ElectronAsh/MiSTer_Vector/README.md

# MiSTer_Vector
Vector X/Y/Z/R/G/B DAC Board for MiSTer

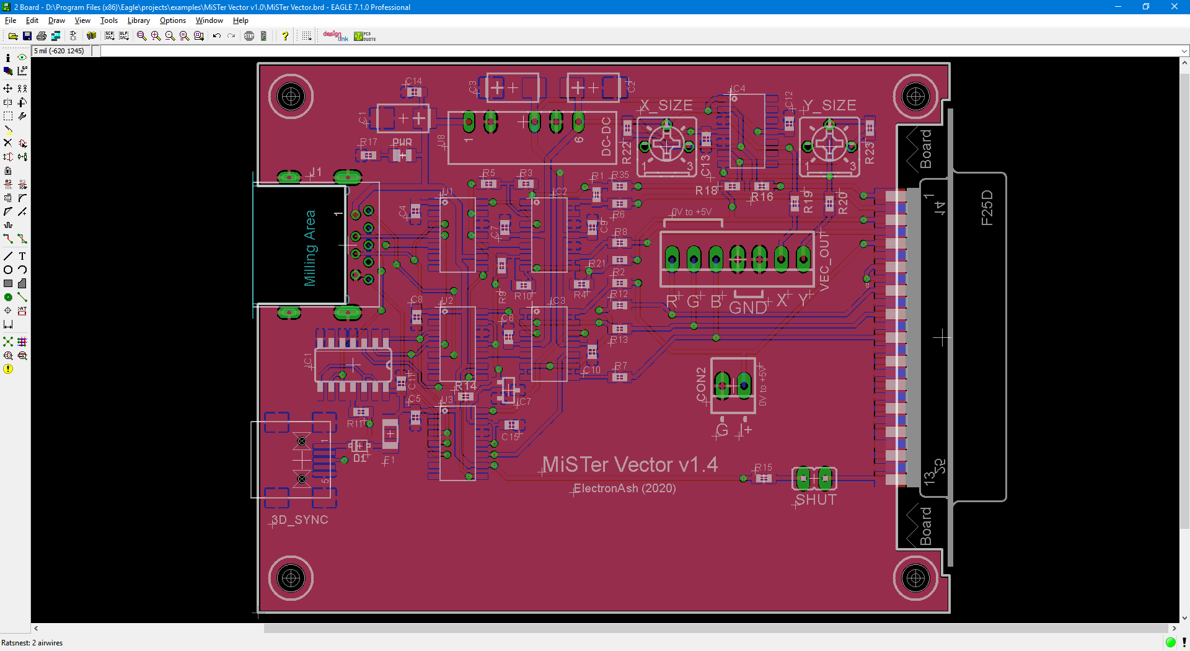
[picture p1: vector_dac_v1_4_PCB.png]
