ElectronAsh/MiSTer_Vector/MiSTer Vector.brd

## EAGLE design MiSTer Vector.brd (2020-01-31)

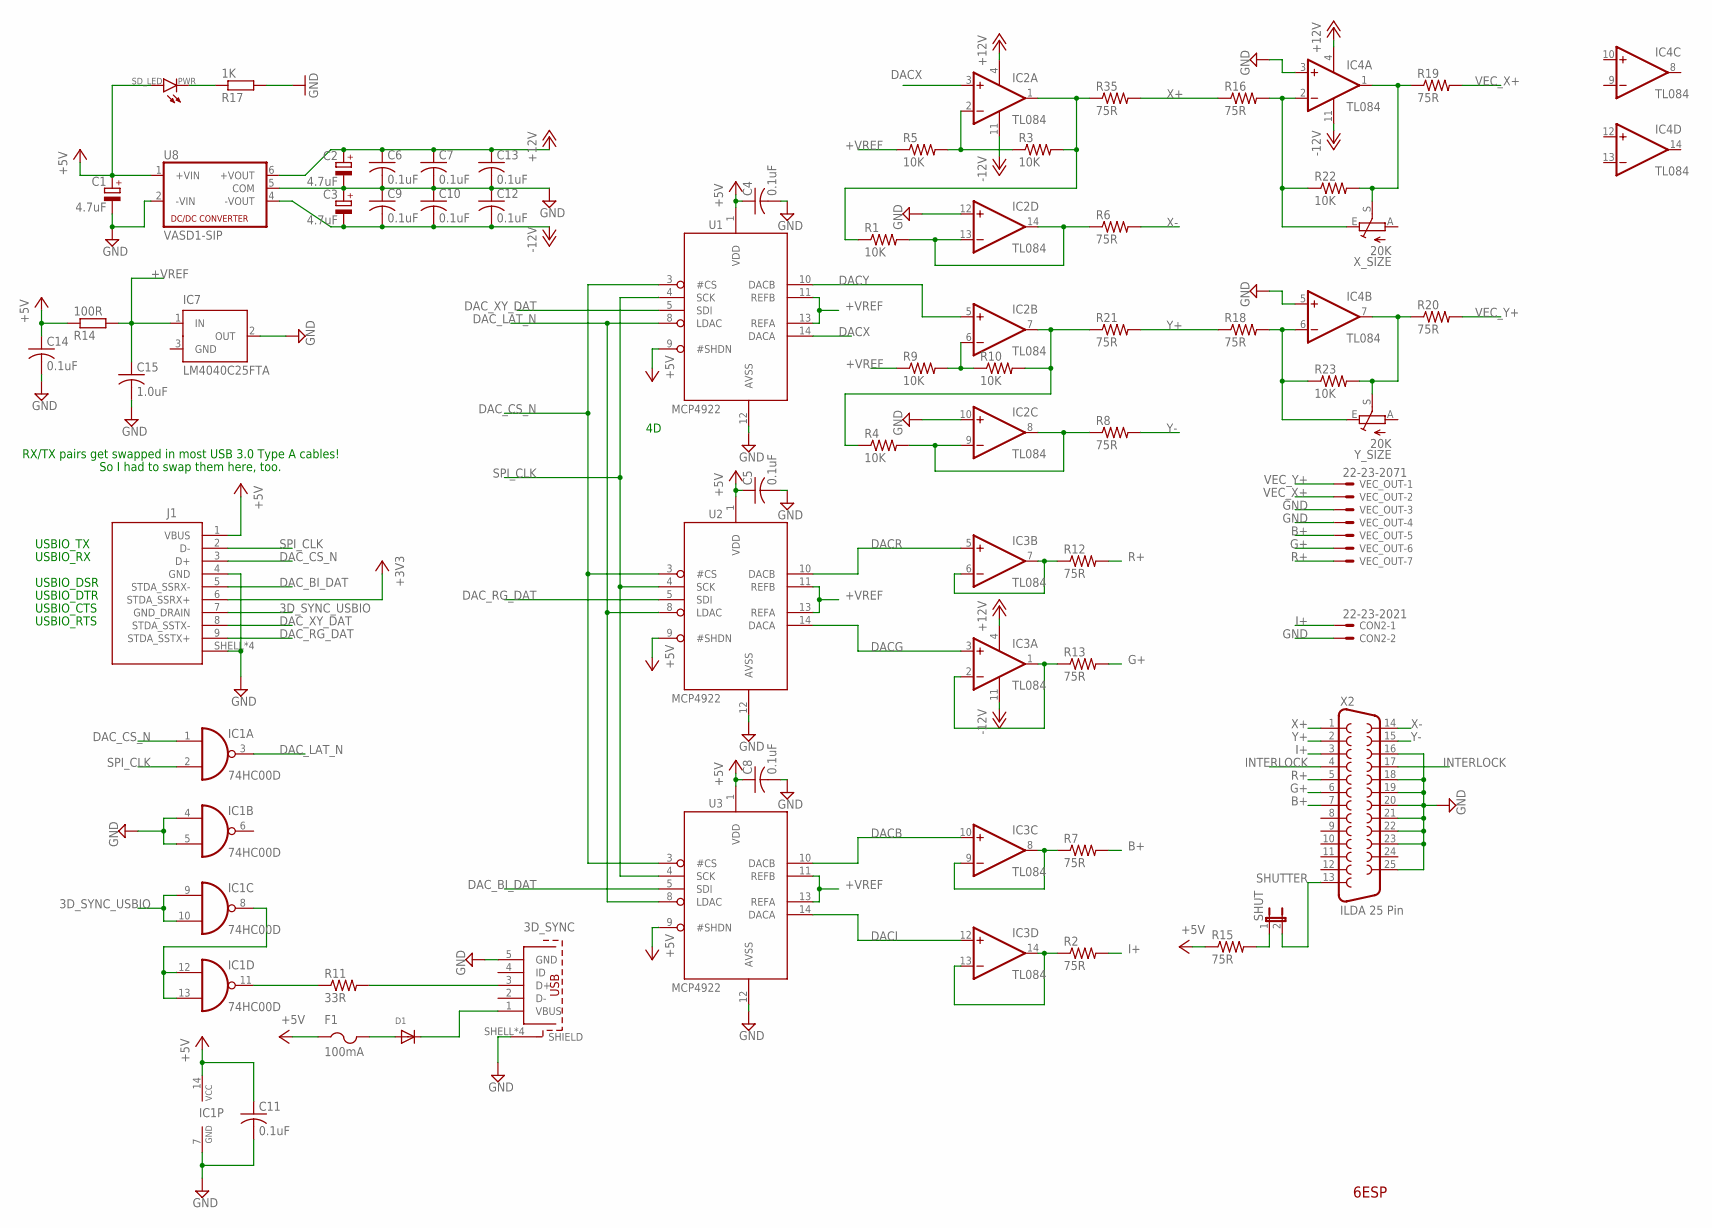
[picture p2: schematic MiSTer Vector.sch]

Parts:
3D_SYNC: 65100516121
C1, C2, C3: 4.7uF; CT6032
C4, C5, C6, C7, C8, C9, C10, C11, C12, C13, C14: 0.1uF; C0603
C15: 1.0uF; C0603
CON2: 22-23-2021
D1: DIODESOD-323F; SOD-323F
F1: 100mA; R1206
IC1: 74HC00D; SO14
IC2, IC3, IC4: TL084; SOIC-14
IC7: LM4040C25FTA; SOT23
J1: 692121230100
PWR: SD_LED; 0805_POL
R1, R3, R4, R5, R9, R10, R22, R23: 10K; R0603
R2, R6, R7, R8, R12, R13, R15, R16, R18, R19, R20, R21, R35: 75R; R0603
R11: 33R; R0603
R14: 100R; R0603
R17: 1K; R0603
SHUT: JP1E; JP1
U1, U2, U3: MCP4922; SOIC-14
U8: VASD1-SIP; NMA
VEC_OUT: 22-23-2071
X2: ILDA 25 Pin; F25D
X_SIZE: 20K; B25P
Y_SIZE: 20K; B25P

Connections:
3D_SYNC_USBIO: IC1.9 (I0), IC1.10 (I1), J1.7 (GND_DRAIN)
+3V3: J1.6 (STDA_SSRX+)
+5V: C1.+, C4.1, C5.1, C8.1, C11.1, C14.1, F1.1, IC1.14 (VCC), J1.1 (VBUS), PWR.+ (A), R14.1, R15.1, U1.1 (VDD), U1.9 (#SHDN), U2.1 (VDD), U2.9 (#SHDN), U3.1 (VDD), U3.9 (#SHDN), U8.1 (+VIN)
+12V: C2.+, C6.1, C7.1, C13.1, IC2.4 (V+), IC3.4 (V+), IC4.4 (V+), U8.6 (+VOUT)
+VREF: C15.1, IC7.1 (IN), R5.1, R9.1, R14.2, U1.11 (REFB), U1.13 (REFA), U2.11 (REFB), U2.13 (REFA), U3.11 (REFB), U3.13 (REFA)
-12V: C3.-, C9.2, C10.2, C12.2, IC2.11 (V-), IC3.11 (V-), IC4.11 (V-), U8.4 (-VOUT)
B1+: IC3.8 (OUT), IC3.9 (-IN), R7.1
B+: R7.2, VEC_OUT.5, X2.7
DACB: IC3.10 (+IN), U3.10 (DACB)
DACG: IC3.3 (+IN), U2.14 (DACA)
DACI: IC3.12 (+IN), U3.14 (DACA)
DACR: IC3.5 (+IN), U2.10 (DACB)
DACX: IC2.3 (+IN), U1.14 (DACA)
DACY: IC2.5 (+IN), U1.10 (DACB)
DAC_BI_DAT: J1.5 (STDA_SSRX-), U3.5 (SDI)
DAC_CS_N: IC1.1 (I0), J1.3 (D+), U1.3 (#CS), U2.3 (#CS), U3.3 (#CS)
DAC_LAT_N: IC1.3 (O), U1.8 (LDAC), U2.8 (LDAC), U3.8 (LDAC)
DAC_RG_DAT: J1.9 (STDA_SSTX+), U2.5 (SDI)
DAC_XY_DAT: J1.8 (STDA_SSTX-), U1.5 (SDI)
G1+: IC3.1 (OUT), IC3.2 (-IN), R13.1
G+: R13.2, VEC_OUT.6, X2.6
GND: 3D_SYNC.5 (GND), 3D_SYNC.SHELL (SHIELD), 3D_SYNC.SHELL1 (SHIELD), 3D_SYNC.SHELL2 (SHIELD), 3D_SYNC.SHELL3 (SHIELD), C1.-, C2.-, C3.+, C4.2, C5.2, C6.2, C7.2, C8.2, C9.1, C10.1, C11.2, C12.1, C13.2, C14.2, C15.2, CON2.2, IC1.4 (I0), IC1.5 (I1), IC1.7 (GND), IC2.10 (+IN), IC2.12 (+IN), IC4.3 (+IN), IC4.5 (+IN), IC7.2 (OUT), IC7.3 (GND), J1.4 (GND), J1.SHELL (SHIELD), J1.SHELL1 (SHIELD), J1.SHELL2 (SHIELD), J1.SHELL3 (SHIELD), R17.2, U1.12 (AVSS), U2.12 (AVSS), U3.12 (AVSS), U8.2 (-VIN), U8.5 (COM), VEC_OUT.3, VEC_OUT.4, X2.16, X2.18, X2.19, X2.20, X2.21, X2.22, X2.23, X2.25
I1+: IC3.13 (-IN), IC3.14 (OUT), R2.1
I+: CON2.1, R2.2, X2.3
INTERLOCK: X2.4, X2.17
unnamed: IC2.1 (OUT), R1.1, R3.2, R35.1
unnamed: IC2.7 (OUT), R4.1, R10.2, R21.1
unnamed: IC2.6 (-IN), R9.2, R10.1
unnamed: IC2.8 (OUT), IC2.9 (-IN), R4.2, R8.1
unnamed: IC2.13 (-IN), IC2.14 (OUT), R1.2, R6.1
unnamed: 3D_SYNC.1 (VBUS), D1.C
unnamed: IC1.11 (O), R11.1
unnamed: IC1.8 (O), IC1.12 (I0), IC1.13 (I1)
unnamed: 3D_SYNC.3 (D+), R11.2
unnamed: PWR.- (C), R17.1
unnamed: D1.A, F1.2
unnamed: R15.2, SHUT.1
unnamed: IC4.2 (-IN), R16.2, R22.1, X_SIZE.E
unnamed: IC4.6 (-IN), R18.2, R23.1, Y_SIZE.E
unnamed: IC4.7 (OUT), R20.1, R23.2, Y_SIZE.S
unnamed: IC4.1 (OUT), R19.1, R22.2, X_SIZE.S
unnamed: IC2.2 (-IN), R3.1, R5.2
R1+: IC3.6 (-IN), IC3.7 (OUT), R12.1
R+: R12.2, VEC_OUT.7, X2.5
SHUTTER: SHUT.2, X2.13
SPI_CLK: IC1.2 (I1), J1.2 (D-), U1.4 (SCK), U2.4 (SCK), U3.4 (SCK)
VEC_X+: R19.2, VEC_OUT.2
VEC_Y+: R20.2, VEC_OUT.1
X+: R16.1, R35.2, X2.1
X-: R6.2, X2.14
Y+: R18.1, R21.2, X2.2
Y-: R8.2, X2.15

Notes on the sheet:
6ESP
USBIO_TX
USBIO_RX
USBIO_DSR
USBIO_DTR
USBIO_CTS
USBIO_RTS
RX/TX pairs get swapped in most USB 3.0 Type A cables!
So I had to swap them here, too.

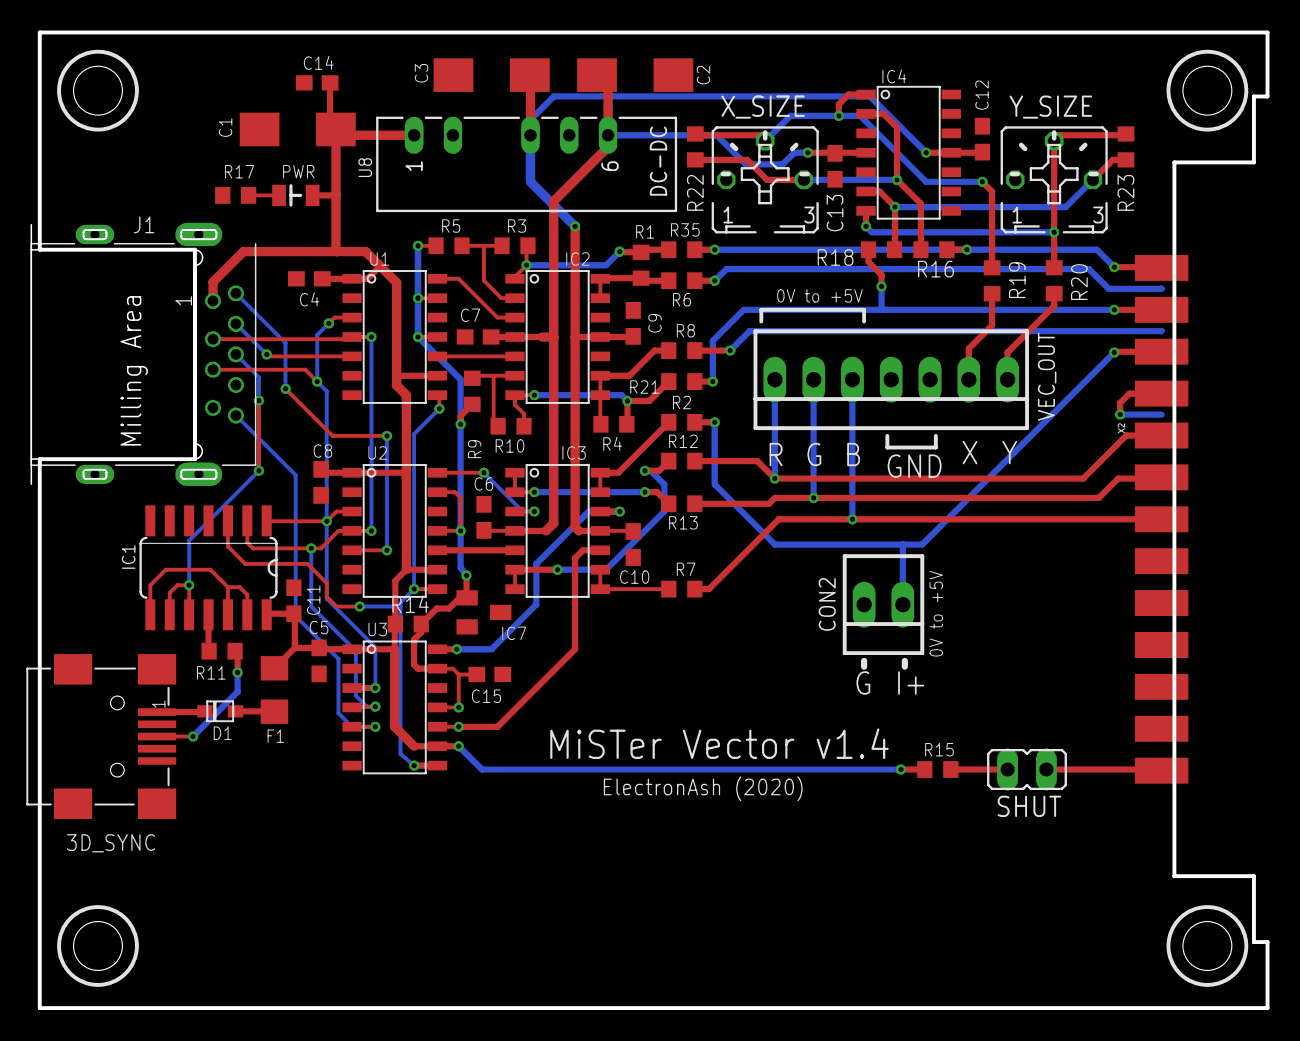
[picture p3: board MiSTer Vector.brd from above]

Board: 2 copper layers, 80.9 x 63.9 mm, 59 parts (0 on the bottom side), 51 nets.
