ElectronAsh/MiSTer_Vector/(threads)

Thread 1 (2020-12-24):

Faster Dac possible? LTC2666

BugWhacker, 2020-12-24:
Would using 1 - LTC2666 Dac running @ 50mhz allow for faster drawing rates? [https://www.analog.com/media/en/technical-documentation/data-sheets/2666fa.pdf](url)

I seems like it would allow for not only faster SPI bus speeds but also less overhead since you can load all registers at once. I have an evaluation board and would be more than willing to try the code out on it if it is something you are interested in working on.

ElectronAsh, 2020-12-25:
Hi,

After testing the prototype DAC, I found that it still wasn't really fast enough for even the Vectrex core.

The SPI DAC does update the X/Y, R/G, and B/I DACs at once from the core, but even when overclocking SPI to 24 MHz, it's still not fast enough, sadly.

(I really should have done a better README on this repo, but I forgot. lol)

It's not so much the update rate from the core itself as the logic used to emulate the analog integration/interpolation, which updates at a much higher rate.

The vector output from the current DAC isn't great.
There's just not enough definition there to really call it usable.

I did look into few other SPI DACs, but I don't think any of them will be quite fast enough either.

The LTC2666 requires a minimum of 24 clock cycles just to update one DAC (or you can latch that same value into multiple DACs).

So at 50 MHz SPI, you would only be able to update each DAC output at around 2 MHz. Which sounds like it would be fast enough, but I also had the issue of the value from the core updating asyncronously to the DAC.

Since you ideally need to shift the data into two DACs before latching (for X/Y), that further reduces the update rate to around 1 MHz.

Using the USERIO port on MiSTer probably wouldn't quite reach 50 MHz reliably either, as the IO Boards have 100R series resistors and 10K pull-ups on all IO pins.

The MiSTer framework logic uses open-drain style outputs now.
(Although you could just force that to push-pull style on the core, it's probably not ideal for some other USERIO add-ons like SNAC were left plugged in.)

I recently designed an ITX/DTX board for MiSTer, though, which has some latches and an ADV7123 DAC for the Vector output...

https://twitter.com/AshEvans81/status/1335018482472263682?s=20

Using two of the ADV's 10-bit DACs for X/Y, and one of the latches for 18-bit RGB, I should be able to very quickly alternate between the two, updating them from the parallel GPIO bus, and updating at a MUCH faster rate.

As a way of enabling the new Vector DAC (and disabling the normal VGA/RGB output), I put a small ATmega on the board which is hooked up to the I2C bus on the DE10's "RTC" header.

(the idea being that when a Vector DAC enabled core is active, it will keep sending out a core ID via I2C, so the ATmega can switch over to the proper DAC.)

For now though, I'll just be forcing those signals during testing.
I just haven't had chance to finish soldering the ADV DAC and the rest of the passives. lol

The only other way I thought it may be doable via USERIO is latching four bits at a time to parallel DACs.
But when I did some calcs for that, I dont think it worked out that much faster than updating all six DACs at once (XYRGBI) via SPI.

If a specific vector core doesn't need full RGB colour, then it might be worth lookng into again in the future.

I'll probably end up deleting this SPI DAC repo eventually, tbh, as I don't think it's quite viable now.
There are some other vector cores being released very soon though, and maybe the SPI DAC will work better with some of those?

Thanks for your suggestion. It's always worth looking into other options. ;)

I'll keep this issue open, and let you know if the new DAC works out.

BugWhacker, 2020-12-26:
Thank you for answering, I have been following your work for awhile and enjoy hacking at hardware myself. I wonder if you could feed the signal out over usb like is being done with the Raspberrypi and advanced Mame. I have one of the boards and it is nothing more than an A-tiny interpeting a usb feed from the pi (or a pc) and dumping an Spi stream into some parralel dacs. It works really well and if it was fpga instead of mame emulation I would be completly happy.

I have been working on a jamma daughter board that I am really happy with the results of so far and having vector support for the mister is a holy grail project for me so I hope you keep working at it or at least dont delete the work you have done already.

If you ever finish your itx setup I would be interested in buying one to play with.
________________________________
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

BugWhacker, 2020-12-26:
I mispoke earlier. The usb fed spi dacs are actually using a teensy 4.1 as a Bridgeboard. It runs at 480mb/s accross usb and appears to keep up wirh eveything I have thrown at it. Maybe the programming you have done could be adapted for that?
________________________________
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

ElectronAsh, 2020-12-26:
Yep, it's possible one of the existing USB vector DACs could be used.

It would then have to send the data to the HPS, though.

MiSTer currently uses one generic 32-bit wide port to allow the HPS to talk to the FPGA/core, and that does also get used for things like transferring data on-the-fly to the CD cores.

It's peak transfer rate is only around 1.6 MBytes/sec, IIRC. Which isn't too bad, but I would worry about having a contiguous enough stream of data to send to the vector DAC.

(what with that same bus being used for OSD updates and other core control stuff.)

I might look again at using latches on the USERIO port, as there are 7 IO pins there, so we could try latching 5 bits of data at once, leaving one pin to reset the counter for which latch to use, and the other pin as a clock.

That would let it load 10-bit data into each latch (X,Y,R,G,B), within only 10 clock cycles.

With the old DAC, it seemed to "work" OK even when pushing the SPI clock up to 24 MHz on the USERIO port.

So if we call it 20 MHz to be safe, that's 50ns per clock cycle, which would allow loading of all five DACs within 500ns.
That's still only an update rate of 2 MHz, though.

So yeah, I'm thinking maybe using the GPIO port is still the way to go. lol

I am still working on testing the DTX mobo, but I ordered the wrong size chips for the latches.
I'm also working on a new variant of the board, which will probably have the vector stuff as an add-on daughterboard.

(since it's fairly niche, and not everyone will want it. It will probably also ditch the PCI slots, and keep the DTX board as a separate project.)

Worth looking into using USB, but I do worry about things like making sure the data doesn't glitch, or is fast enough for the more advanced vector cores. I've not tried MAME with vector output yet, but that could be interesting.

I think it would be much nicer having a more "direct" vector output from the FPGA, with super low latency etc., and no software / OS issues to worry about. ;)

I don't have a proper vector arcade monitor, only the 14" Philips TV that I modded, plus the HV Board and deflection boards I built.

It's good enough for basic testing, but I'd love to get hold of a small-ish vector monitor at some point.

Thanks again for your support.

I might just leave this repo here for historic reasons, and I'll update the README soon, to let people know that the SPI DAC probably isn't workable at this point.

It didn't produce really terrible vectors, and maybe it would look far better on a proper monitor, but I have a feeling the vectors still wouldn't look especially crisp.

Thanks for your support. ;)

If I manage to get the new DAC running OK on this DTX board, I'll likely be posting updates on Twitter.

ElectronAsh, 2020-12-26:
Oh, yep...

There is the AXI bus on the FPGA which is capable of MUCH faster transfer rates, and isn't currently used on any core.

(aside from a few test cores like for Laxer's PS1 GPU, and some debug stuff I did.)

Sorg said he tried using AXI from the start, but he found it had issues with crashing the HPS (ARM) whilst loading a new core.

I can see how that could happen, since the HPS bus freezes if there's no logic loaded on the FPGA at the time it tries to read/write data via the AXI bus.

I've not had that specific problem so far during testing, but I think it's worth looking into as it's very easy to set up now.

I'm thinking maybe with some code on the HPS that keeps polling the core to make sure it's AXI-enabled might work.

Even when configured as a 32-bit wide bus, and not even using DMA, you can get transfer rates of around 25 MBytes/sec via AXI.

If I ever get time, I might try the Teensy thing, though.
Could be worth finding out what the typical DAC update rate is on various MAME vector games.

That would give a ballpark figure to aim for with the USB DAC / core logic.

BugWhacker, 2020-12-26:
I can answer the dac question for you as I repair the monitors and boards. 4 - 6 mhz max. Is the hardware limit of the dacs used and the max switching speed of the transistors in the deflection circuit of the monitors. If you decide to look into the teensy dac driver and need a Guinea pig I have the board and real arcade monitors. I bett8ng that if you had a Paetron account you could get supporters.
________________________________
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

BugWhacker, 2020-12-26:
So, I have slept on it and had some more thoughts on vector output. I understand the need to keep everything on the fpga side of things since the Linux side doesn't really have that much resources available for extra data transfer or even a more complex OSD that outputs in vector.

Keeping that in mind and either needing to program a vector output menu system for launching cores or accept the idea of 2 monitors - 1 vector and one other for menu functions ( I actually launch cores over telnet when testing so I plan to use a touch screen in my arcade machine marquee area connected to a raspberry pi sending telnet commands back to the Mister...) I think that using the digital i/o board setup to have an entire GPIO port available that is unused is a good starting point ( so far anyway - I know they are eyeing that port for dual sdram in the future but my thinking is that all vector games that currently exist will run fine on current sdram boards and I don't see them needing more in the future).

Now that we have a free GPIO port just sitting there ready to abuse why not make use of it with multiple Spi ports - 3 of them? Have each Spi port hooked up to a fast dac ( Dac7811 maybe? its cheap, fast and stable - It runs at up to 50mhz, 12-bit, current output for driving quadrature,  small but still hand solderable)  1 each of them for x and y for the quadrature output since x/y must be in the right place at the right time always. For the RGBI a quad channel will do and it doesn't need the same speed and precision ( DAC7564 ? 50 mhz, 12-bit, voltage output since all voltages output needed will be positive)

Do you think there is enough resources available on the fpga to run 3 spi outputs across the gpio port? Or maybe consider running 6 and using 6 - Dac7811?

My ultimate goal for all of this is to have a de-10 daughter board like the one I am finishing up for Jamma arcade cabinets. I want to make a similar one that allows for using vector monitors in arcade cabinets. Maybe someone will port the menu side of -  https://github.com/ChadsArcade/VMMenu to the Mister framework? Then we would only need one monitor to have a menu system to launch games with.
[https://avatars2.githubusercontent.com/u/54304827?s=400&v=4]<https://github.com/ChadsArcade/VMMenu>
GitHub - ChadsArcade/VMMenu: Vector Mame Menu for ZVG<https://github.com/ChadsArcade/VMMenu>
You can also edit the display name if you wish, but do not alter the clone name or parent game name or the game may not run. New for v1.3 - You can now show or hide games from within the menu itself, simply access the show/hide games option from the settings page.. New for v1.3.2 - [Added by DanP] An autostart game can now be configured, this will run prior to the menu starting so gives a more ...
github.com

Let me know what you think-

Keith

________________________________
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

ElectronAsh, 2020-12-27:
Plenty of logic left on the FPGA for basic SPI outputs etc.

And yep, that 4-6 MHz sound pretty high. Amazing how fast those older boards worked really, and how fast the yokes could be driven vs their inductance etc.

The main challenge on Vectrex was just routing the DAC outputs to the top level, tbh. It was a bit harder due to the fact that the core itself is written in VHDL, and I've never got on too well with that. lol

The extra logic for driving the old SPI DACs didn't take too long to write.
And had some help with the signed values, though, as it's not something I've had to use too often in Verilog.

IIRC, the Vectrex core converts the integrated DAC output to 10-bit signed values, so I had to convert those to unsigned, then centre the image to work properly with the SPI DAC.

Yep, I think writing some logic to duplicate the MiSTer OSD menu on a vector monitor could be interesting.

Maybe something similar to how the Vectrex usually displays text, with a raster-like display. That's assuming a typical deflection amp and monitor is fast enough to display the text cleanly enough.

Due to the speeds required, it might be necessary to blank the vector output from the core while the OSD is active, but I think that's a good compromise.

I have no idea about how to do the maths for proper vector stuff yet, though. ie. if it involves things like doing a proper vector-based font, with all of the correct timings.

Maybe just using a simple state machine to draw a raster would work OK for the OSD window.
Then it would just be a case of modulation the RGB (or mono) output for the text, based on the contents of the OSD buffer.

IIRC, the OSD buffer on MiSTer only uses 4KB of on-chip RAM, so it wouldn't use too much to just add a second block.

(since it's already using a dual-ported RAM block for writing and display, it would likely need a separate block to use for the raster-on-vector output. The same contents gets written to both, it just allows us to read that out at a different rate for display via vector.)

The thing with the GPIO port is that if you don't need to use the old VGA/RGB output when using a vector monitor, then the VGA port (and analog audio) can simply be disabled when a vector core is running. You'll still have the HDMI output available for cores that convert vector to raster.

That's basically what my DTX mobo is doing, so using a digital IO board isn't too much of a requirement.
And then you have plenty enough IO pins to just use some latches and parallel DACs, which could potentially make the design a bit cheaper.

But to have higher than say 8-bit precision for the X/Y output, I just ended up using the ADV7123 to get 10-bits.

(Getting enough out of the extra precision using discrete resistor-ladders beyond about 7 or 8 bits is tough, so might as well use a proper DAC chip.)

I've ordered more latch chips for the DTX board. Let's hope I got the package correct this time. lol

I'm using the same opamp circuit as on the old SPI DAC, with the DC-DC converter for generating the +/- 12V rails.

The main issue for me atm (beyond getting the new vector stuff running) is just finding the time to do all of this stuff. lol

Some very interesting new vector cores around the corner though, as I say.

Alan has been working hard on porting some new cores over to MiSTer. I've not had chance to try this yet...

https://github.com/alanswx/Arcade-BattleZone_MiSTer

ElectronAsh, 2021-01-05:
Still no sign of the latch chips for the DTX board, so I can't test the vector DAC yet.

Also just bought another "resistor book", as I was running low on quite a few values.

Lots of other MiSTer-related stuff happening though, so quite busy atm.

I'll try to remember to update this issue if/when I get the chips and can test the vector output.

Would be great to try it with BattleZone at some point.

Ash.

BugWhacker, 2021-01-05:
I am buying a DE0-nano card & vector adapter that can run Major Havoc, Asteroids, Quantum in Vector so I will have another insight into how someone else has gotten color Vector to work from an fpga board. From the amount of pins they are using I think they are using multiple parallel interfaces instead of SPI. I will let you know when it gets here what they are doing. The code that runs it is not in the open source realm though but just knowing it can run well is enough of encouragement to move forward.

Keith
________________________________
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

ElectronAsh, 2021-01-05:
I definitely know the one. Scott Swazey. hehe

I watched this about three times when it was first released...

https://youtu.be/NVzlWMWNjeQ?t=1887

He's using both 40-pin GPIO headers, but I think quite a few IO pins are for the player controls etc.
Also looks like at least 8-bit parallel DACs, which would be enough.

Don't worry, I still have plans for this. I'll be doing an add-on board once I'm done with testing the next MiSTer-related PCBs (which are being made right now).

I can't say that will happen very soon, though. It's going to be a couple more months until I have the vector add-on done.

crdotson, 2022-01-06:
It just so happens that I'm exactly a year later -- hopefully just under the wire on necroposting?  I'm a novice at the MiSTer so I don't think I'm able to help with much other than testing, but I wanted to comment to say that I've been following this since your original twitter post and I'm definitely interested in the progress!  I've got an Asteroids cocktail with no logic board that's just screaming for this.

ElectronAsh, 2022-02-18:
Sorry for the very late reply.

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

Thread 2 (2022-10-16):

Readme question

smdjeff, 2022-10-16:
Is the edge connector to get 12VDC from an arcade machine?

Is the interface to Mister the J1 connector?  Why doesn't this plug into the 40pin?

ElectronAsh, 2022-10-17:
Hi,

The 25-pin D-Sub has a ILDA standard pinout, for use with RGB Laser projectors, since I wanted to try driving those from MiSTer as well as vector monitors.

There's a more typical connector just to the left of that, for driving vector monitors.

The "USB 3.0" style connector is so MiSTer can drive this board via the USERIO/SNAC port.

The prototype worked OK with the MiSTer Vectrex board driving an actual Vectrex monitor, but it did have a few issues.
Mainly there was a weird strobing effect of the vector lines, probably due to the DACs not updating fast enough.

The USBIO port doesn't quite have enough pins to have enough bandwidth via SPI to drive the DACs faster.

The SPI DACs I used are the MCP4922. They are pretty good DACs, and have up to a 12-bit resolution.
They can be overclocked to around 24 MHz or so SPI SCLK freq via the MiSTer USERIO port, but that still doesn't solve all the issues.

One problem with the DACs is that there are two DACs in each chip, so it takes around 16 or so SPI clock cycles to load data into both DACs, so the analog outputs can be updated simultaneously (by pulsing the LDAC pin Low.)

So yep, ideally for the faster arcade vector games, it's probably better to look into doing board that hooks up to the 40-pin header on MiSTer, using R2R DACs or some other parallel DAC chips. If you can latch data into five parallel DACs within only a few clock cycles, then you'd havea *very* fast update rate that I'm sure would work for a lot of vector arcade cores.

I have also done a PCB design with latches and parallel DACs onboard.
It was starting to work well, but I got stuck into too many other projects. lol

Hopefully we'll start seeing more arcade vector cores being implemented in the coming years.

I don't own a proper arcade vector monitor, but I have converted a 14" colour TV CRT into a vector, by rewinding the vertical yoke.

I've been using this deflection amp design for testing...
http://www.e-basteln.de/arcade/asteroids/monitor/

I designed a PCB for the flyback, which worked quite well on the 14" CRT.
I can't remember if I got the RGB driver transistors working properly, though. It was a while ago...

https://twitter.com/AshEvans81/status/1266463917338959874?s=20&t=X-vqS1-l81Paw1HUSqJMyg

I'll see if I can dig out the info on the parallel DAC board, and update here if I find it.
It's basically just some latches on the 40-pin header, some resistor DACs, and opamps.

(It would be possible to design a board that switches between vector and raster output from MiSTer, so you don't lose the standard RGB output for the raster cores.)
