ElectronAsh/MiSTer_Vector/(commit log)

2020-01-03 hook up DE15 pins 6,7,8 to Gnd
    [MiSTer Vector v1.0.brd, MiSTer Vector v1.0.sch]
2020-01-05 driving the DAC chips in parallel now, because FPGAs rule
    [MiSTer Vector v1.0.brd, MiSTer Vector v1.0.sch]
2020-01-09 added 3-pin VESA miniDIN, for 3D glasses
    [MiSTer Vector v1.0.brd, MiSTer Vector v1.0.sch]
2020-01-09 swapped two USBIO pins, for better signal integrity
    [MiSTer Vector v1.0.brd, MiSTer Vector v1.0.sch]
2020-01-09 changed DB15 to DB25, for use with laser projectors
    [MiSTer Vector v1.0.brd, MiSTer Vector v1.0.sch]
2020-01-09 made the PCB longer, to fit a specific project box
    [MiSTer Vector v1.0.brd, MiSTer Vector v1.0.sch]
2020-01-10 changed the miniDIN for a miniUSB, to fit the case
    [MiSTer Vector v1.0.brd, MiSTer Vector v1.0.sch]
2020-01-10 added BOM csv
    [MiSTer Vector v1.0.csv]
2020-01-10 added VREF adj switch and pot, plus ILDA shutter jumper
    [MiSTer Vector v1.0.brd, MiSTer Vector v1.0.sch]
2020-01-12 added size adjustment for Molex output. ILDA fixed to 0-5V
    [MiSTer Vector v1.0.csv, MiSTer Vector.brd, MiSTer Vector.sch]
2020-01-31 swapped USBIO TX/RX pairs, as done in most USB3 TypeA-TypeA cables
    [MiSTer Vector.brd, MiSTer Vector.sch]
2020-01-31 routed the swapped TX/RX pairs on USBIO
    [MiSTer Vector.brd]
2020-04-29 Add the BOM for the v1.4 DAC board.
    [MiSTer Vector v1_4 BOM.csv]
