ElectronAsh/MiSTer_Vector/(notices)

Notices in the files:
parts and their libraries:
632723100011_Eagle_WR-USB_rev19b: Copyright: Würth Elektronik
